dfnr2/asteroids-lunar-multigame-thrust-a2d/(commit log)

2022-01-31 More wiring description.
2022-02-01 Swap each pair of bits in output
    [thruster.ino]
2022-02-01 Add wiring diagram
2022-02-01 Update README.rst
    Add wiring diagram, and fix broken link.
2022-02-01 Fixed labels on header
    Indicate POKEY pin (Px)
2022-02-05 Update README.rst
    Fix malformed cell in potentiometer wiring table
2022-02-25 Move thruster.ino into thruster directory
    - arduino IDE requires .ino to be in project directory of similar name.
2022-02-25 Cleanups and bugfixes
    - Added #defines for mini pro vs nano, to simplify configuration
    - use actual stored max and min ADC values from EEPROM to map ADC to
    desired range. Was using nominal max and min adcraft
    - added the ability to short two pins together to force recalibration of
    the adc
    - Blink LED if ADC is recalibrated.
    - force recalibration of MAX and MIN ADC values in EEPROM are the same.
    Was testing the RAM values, which are always initialized to the same.
    - indentation format fixes.
    [thruster.ino]
2022-03-14 Fix bugs in EEPROM hiva/loval testing on startup
    - untested
    [thruster.ino]
2022-03-15 Finished wiring comments
2022-06-14 Move EEPROM reset check to main loop
    - Instead of checking for an EEPROM reset request at startup, check each
    pass through the loop. EPROM reset is signaled by placing and removing a
    jumper, or by momentarily closing a switch. This simplifies the reset
    process once the multigame is fully installed. A switch can be brought
    out near the thruster behind the cabinet, as part of the thruster
    assembly, etc.
    - Add function headers.
    [thruster.ino]
2022-06-15 Light LED when RESET jumper is shorted
    - Instead of repeating the blink sequence while the RESET EEPROM jumper
    is shorted, jut keep the internal LED on when jumper is shorted (or
    switch is closed) and off when switch is released.
    - remove unused blink_led() function.
    [thruster.ino]
2022-06-15 Require pushbutton or jumper for EEPROM reset
    - Now that the EEPROM can be reset while the system is powered up,
    require the user to initiate an EEPROM reset (i.e., a calibration) by
    pressing a momentary button or placing a jumper.
    [thruster.ino]
2022-06-15 Add "calibrate" switch to wiring diagram
    - Show calibration switch in the circuit
    - Show how to solder wires to the potentionmeter
2022-06-15 Update README to discuss cable
2022-06-16 Change docs to describe eprom calibration pintouts
    - Edit README.rst to describe cable construction for calibration
    - Edit thruster.ino to describe calibration instead of EEPROM ClEAR
    - The calibration pins are moved immediately adjacent to the thruster
    potentiometer pins so a 6-pin connector and cable can be used for
    the pot and the calibration pushbutton.
2022-06-16 Moved thruster.ino from thruster subdir to top Dir
    No need for a subdirectory of just one file.
2022-06-16 Remove static init of lo_adc_val and hi_adc_Val
    - not needed, since setup() reads the values from EEPROM. These values
    are set by performing a calibration.
    - removed references to analog_middle
2022-06-16 Move thruster.ino back to ./thruster/
    - Arduino environment requires the file to be in a project subdir, so
    move back to ./thruster/
    - Also, can't use pin C6 as an I/O pin on the Nano, since it's also
    the /RESET pin, and therefor tied high due to the way we power the
    chip through /RESET pin. So, move the calibration switch pins back to
    A4 and A5 on the Nano.
2022-06-17 Update to cable description
2022-06-18 Updated wiring diagram for pushbutton
2022-06-20 Rename variable reset_request
    calibrate_request is more accurate.
    [thruster.ino]
2022-06-20 fixed a typo
    properly declare calibrate_request
    [thruster.ino]
