dfnr2/asteroids-lunar-multigame-thrust-a2d/(notices)

Notices in the files:
thruster/thruster.ino:
This program is free software: you can redistribute it and/or modify it under
the terms of the GNU General Public License as published by the Free Software
